plp1507/ic-emg/protese/teste_vna1.txt

-9.70184326E+00
-9.70123291E+00
-9.70770264E+00
-9.70526123E+00
-9.69769287E+00
-9.69238281E+00
-9.67559814E+00
-9.66070557E+00
-9.63366699E+00
-9.60742188E+00
-9.54473877E+00
-9.50756836E+00
-9.46258545E+00
-9.42108154E+00
-9.37390137E+00
-9.32885742E+00
-9.28045654E+00
-9.23321533E+00
-9.18292236E+00
-9.13580322E+00
-9.05548096E+00
-9.00695229E+00
-8.96289825E+00
-8.91785431E+00
-8.87543869E+00
-8.83381653E+00
-8.79611969E+00
-8.76023102E+00
-8.72811127E+00
-8.70223236E+00
-8.67369843E+00
-8.65395355E+00
-8.63709259E+00
-8.61933899E+00
-8.60128784E+00
-8.58212280E+00
-8.56149292E+00
-8.53753662E+00
-8.50477600E+00
-8.46829224E+00
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
