plp1507/ic-emg/protese/relatorios_ant/Relatorio Parcial_Renan Prando Davanzo.pdf

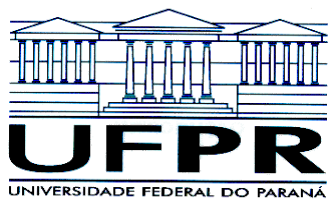
[picture p20: figure]

MINISTÉRIO DA EDUCAÇÃO
UNIVERSIDADE FEDERAL DO PARANÁ PRÓ-REITORIA DE PESQUISA E PÓS-GRADUAÇÃO COORDENADORIA DE INICIAÇÃO CIENTÍFICA E INTEGRAÇÃO ACADÊMICA PROGRAMA DE INICIAÇÃO CIENTÍFICA E EM DESENVOLVIMENTO TECNOLÓGICO E INOVAÇÃO

RENAN PRANDO DAVANZO

RELATÓRIO PARCIAL

INICIAÇÃO CIENTÍFICA:
PIBIC CNPq ( ), PIBIC CNPq Ações Afirmativas ( ), PIBIC UFPR TN ( ), PIBIC Fundação Araucária ( ), PIBIC Voluntária ( X ), Jovens Talentos ( ), PIBIC EM ( ).

INICIAÇÃO EM DESENVOLVIMENTO TECNOLÓGICO E INOVAÇÃO: PIBITI CNPq ( ), PIBITI UFPR TN ( ), PIBITI Funttel ou PIBITI Voluntária ( ).

(Período no qual esteve vinculado ao Programa 12/2017 a 07/2018)

ANÁLISE DE CIRCUITOS PARA APLICAÇÃO EM ELETROMIOGRAFIA

Relatório | Parcial | apresentado | à
Coordenadoria de Iniciação Científica
e | Integração | Acadêmica | da
Universidade Federal do Paraná -Edital 2017/2018 (ano de início e término do Edital).

Marlio Bonfim / Departamento de Engenharia Elétrica

Estudo de Estruturas Magnéticas para Eletrônica de Spin / 2006019145

CURITIBA
2018

ANÁLISE DE CIRCUITOS PARA APLICAÇÃO EM ELETROMIOGRAFIA

RESUMO

O documento relata o trabalho de pesquisa desenvolvido em uma das etapas do projeto de pesquisa, em que aborda o uso de um circuito eletrônico de tratamento de sinais SEMG (eletromiografia de superfície) de baixo-custo, tamanho reduzido e favorável para aplicação em tecnologias “wearables”.

Palavras-chave: Instrumentação, Bioengenharia, Eletromiografia

### 1. INTRODUÇÃO

Os sistemas de aquisição e processamento de sinais biomédicos permitem a análise de estruturas e de processos biológicos e fisiológicos, auxiliando médicos e pesquisadores no processo de diagnósticos e tratamento de doenças ou estudo do corpo humano. Com o avanço da tecnologia e a interdisciplinaridade de campos científicos, a bioengenharia evolui consideravelmente e hoje ocupa um papel importante na medicina - contribuindo com melhorias ou com novidades de métodos de análise de sinais biomédicos - e também na economia -abrindo maiores possibilidades de comercialização de produtos (de monitoramento fisiológico, por exemplo) para cidadãos comuns.
A bioengenharia é um ramo interdisciplinar de engenharia que varia desde a análise teórica, empreendimentos não experimentais para aplicações de última geração [1], utilizando conceitos de biologia, química, elétrica, mecânica, óptica, dentre outros, para auxiliar a área médica. A instrumentação biomédica é uma de suas áreas de estudo, envolvendo aquisição de sinais biológicos, tais como ciclo cardíaco e contração muscular, utilizando sensores e transdutores biomédicos. Os sensores e transdutores biomédicos são responsáveis por transformar sinais biológicos em sinais elétricos, e assim poderão ser tratados e processados por um sistema eletrônico capaz de armazenar esses dados em uma unidade de memória digital ou transmiti-los de alguma forma a um sistema seguinte.
Para detectar movimentos musculares, podemos usar, dentre outros sensores, eletrodos de eletromiografia de superfície. SEMG (Eletromiografia de superfície) é uma técnica não-invasiva para medição da atividade elétrica no músculo que ocorre durante ciclos de contração e relaxamento muscular [2]. Os eletrodos emitem sinais elétricos que devem ser tratados, buscando eliminar ruídos e sinais fora da faixa de frequência desejada e amplificar a amplitude do sinal para viabilizar um processamento digital.
O projeto atualmente se encontra no desenvolvimento de um amplificador de instrumentação para o tratamento de sinais SEMG de tamanho compacto, com poucos componentes e baixo preço de produção, buscando ser confiável, acessível economicamente no mercado e favorável para aplicação em tecnologias “wearables”. Espera-se, em seguida, aplicar o sistema de tratamento de sinais SEMG em sistemas digitais para processamento e aquisição digital para acionamento de próteses. A atuação do aluno está voltada à análise teórica, simulações computacionais e modelagem matemática do sistema, auxiliando nas escolhas dos componentes eletrônicos e contribuindo para a criação do método de projeto do circuito de amplificação proposto.

### 2. REVISÃO DA LITERATURA

Os amplificadores de instrumentação comumente realizam o tratamento do sinal através de diversos estágios, ou seja, são usados amplificadores e filtros em cascata [3] para adequar o sinal elétrico gerado pelos sensores, de modo a permitir a leitura desses sinais por um sistema de processamento ou aquisição digital. Porém, as aplicações de sistemas de aquisição e processamento de sinais SEMG caminham para tecnologias “wearables”, onde o trabalho de otimização de espaço do circuito eletrônico é essencial para a viabilidade prática do projeto [4].

### 3. MATERIAIS E MÉTODOS

3.1 O Sinal Eletromiográfico

O movimento muscular nos permite realizar tarefas como andar, ficar sentado e empurrar objetos graças às contrações musculares. A ação muscular é acionada por sinais elétricos recebidos de um nervo motor [5]. Pela Lei de Faraday, os sinais elétricos gerando ondas eletromagnéticas que se propagam pelos tecidos do corpo até a superfície corporal. Os eletrodos detectam essas ondas e transformam em pulsos elétricos. A amplitude do sinal SEMG é um sinal estocástico que pode ser razoavelmente representada por uma função distribuição Gaussiana. Amplitudes e bandas de frequências típicas são de 0 a 10 mV e 5 a 500 Hz [6], ilustrado na figura 1, a esquerda, a resposta no tempo onde podemos notar as amplitudes de tensão do sinal, e a direita, a resposta na frequência que mostra a região de frequências mais importantes para análise de sinais SEMG. A localização e o tipo de material do eletrodo mudam ligeiramente as características de detecção e sinal de saída.

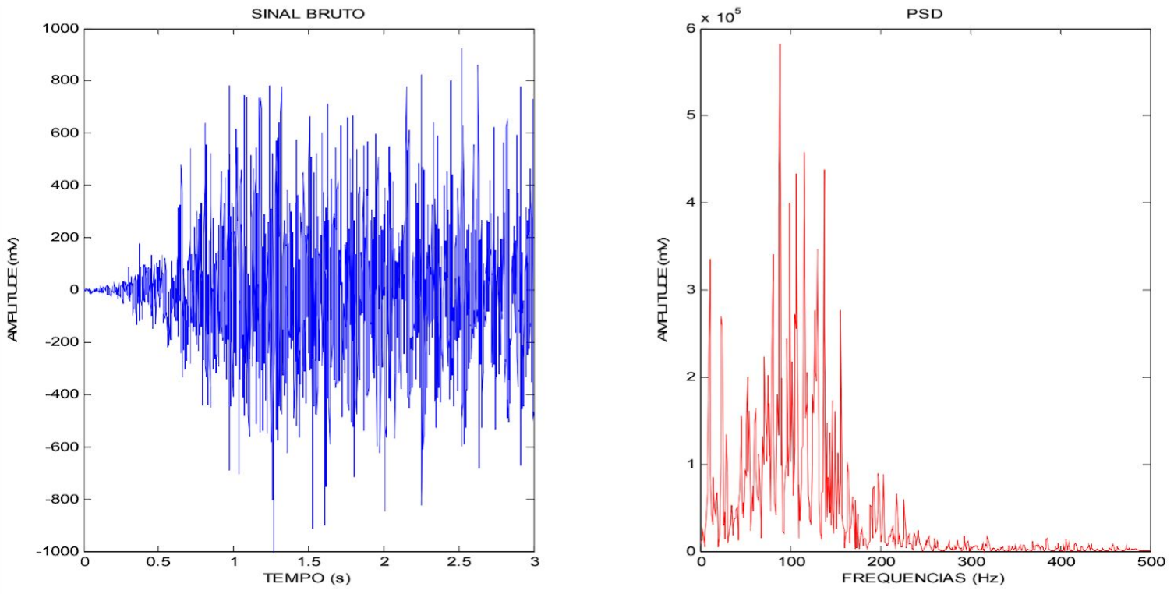
[picture p21: figure]

Figura 1: Gráfico representativo dos componentes do sinal EMG bruto (análise temporal e de frequências, respectivamente) [7]

3.2 - Sistema de tratamento do sinal SEMG

A utilização de um filtro de sinal se faz necessária para amplificar a amplitude do sinal e remover ruídos. O circuito projetado é composto por um amplificador diferencial para tratar sinais de dois eletrodos de eletromiografia de superfície. A amplificação diferencial detecta a diferença de potencial entre os eletrodos e cancela as interferências externas [8], como ruídos ambientes, movimento dos componentes, e inerentes aos próprios componentes utilizados, devido a rejeição de modo comum. Uma das fontes de ruído mais importantes é da alimentação na rede elétrica (60 Hz, no Brasil), e o tratamento de sinal deve atuar eficientemente para atenuar esse ruído a níveis desprezíveis de tensão. Além disso, o amplificador deve contar alta impedância de entrada, para o bom casamento de impedância alta do eletrodo.
O esquema elétrico do circuito projetado está representado na figura 2. Os eletrodos estão representados como fontes de tensão V1 e V2, conectadas na porta não inversora dos amplificadores operacionais OP1 e OP2, respectivamente. A relação entre as resistências dos resistores R1 e R2, além do ramo com o resistor RA e CA, afetam na amplificação do sinal SEMG (será discutido mais adiante).

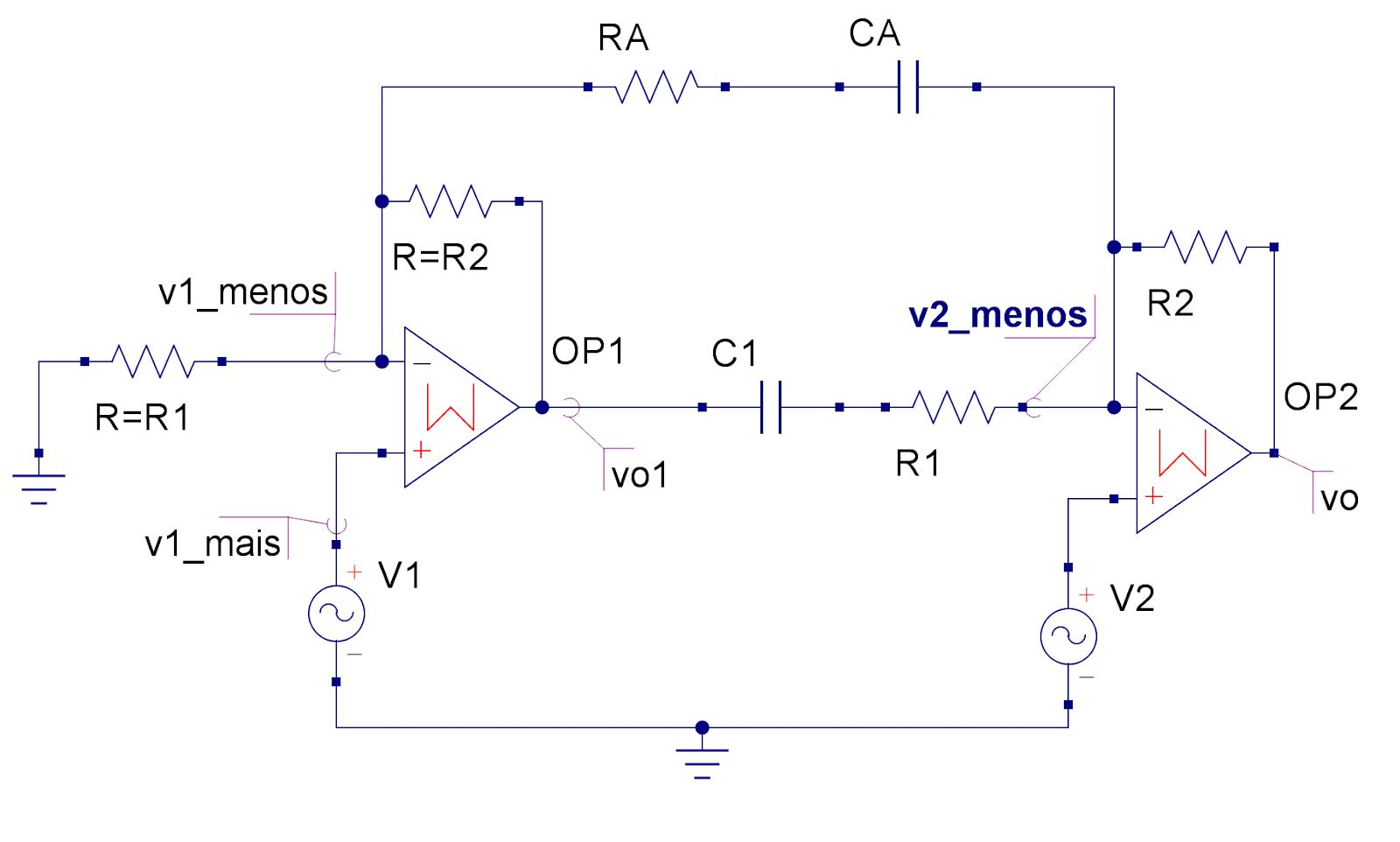
[picture p22: figure]

Figura 2: Esquema elétrico do circuito de tratamento de sinal sEMG

É utilizado o CI LM324N, um circuito integrado com quatro ampops (amplificadores operacionais) independentes, de alto ganho e com compensação interna de frequência [9]. Esses amplificadores apresentam resistência de entrada na ordem de 100 MΩ, ganho de malha aberta máximo de 1000 e CMRR mínimo de 60 dB para ganho unitário e 85 dB para ganhos entre 100 a 1000 [10].

3.3 Modelagem matemática do sistema de tratamento de sinal

O ganho de tensão de um amplificador diferencial é dado pela razão entre o nível de tensão na saída pela diferença entre os níveis de tensão dos sinais de entrada v1 e v2, ou seja

A (1)

v, dif =

vo
v −v 1 2
O ganho de tensão em modo comum é dado pela equação A (2)

v, cm =

vo
v +v 1 2
O fator de rejeição de modo comum é dado por

### CMRR = (3) Av, cm

Av, dif

Seja Ao o ganho de tensão do ampop. Os ampops com compensação interna de frequência, como do CI LM324N, apresentam o ganho Ao dependente da frequência do sinal de entrada de acordo com a equação no domínio de Laplace

Ao = | (4)

Go
1+
| s ωo

sendo Go o ganho de tensão do ampop em malha aberta e ωo a frequência angular de corte. [11]

Sejam R , | e | os valores da resistência elétrica dos resistores R1, R2 e R3, 1 | R2 | R3
respectivamente, do circuito apresentado na figura 2; C1 e CA os valores de capacitância dos
capacitores C1 e CA, respectivamente; v e | as tensões das fontes V1 e V2; e | e | as 1 | v2 | vn
− | vn

+

tensões nas portas inversora e não inversora, respectivamente, dos amplificadores operacionais (OPn, sendo n={1,2}) do circuito da figura 2.
A impedância da associação em série do resistor R1 e capacitor C1 pode ser representada pela expressão no domínio de Laplace
Z3 = R1 + | (5),
| 1 s·C1

assim como para RA e CA,
ZA = RA + | (6)
| 1 s·CA

Para modelagem matemática do circuito, analisamos primeiro o amplificador operacional OP1. Considerando impedância de entrada do OP1 infinita, fazemos a análise de nós (Lei das Correntes de Kirchhoff) no nó da porta inversora de OP1:

v | (7)
1

− =
2 +

R1
ZA

v +v · o1

−
2

R1
ZA

A tensão de saída de um amplificador operacional de tensão é o produto do ganho de tensão do amplificador operacional com a diferença de tensão entre a porta não inversora e a porta inversora.

Então, a tensão de saída de OP1 é dada pela equação
v | (8) o1 = Ao ·(v1 − v
1

−)

Fazendo o mesmo procedimento para OP2, temos, pela Lei das Correntes de Kirchhoff,

v | (9)
2
− = (R //Z //Z ) 1 | A | 3

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
+ Z3

vo1 )

e pela equação de tensão de saída de um amplificador operacional de tensão,
vo = Ao ·(v | (10) 2 − v
2

−)

Então, podemos encontrar v :
1

−

v | v
1

− = vo ·

ZA

R //Z //Z
1 3 A
2+Ao+ +R · | · | −

R1
ZA

1 ZA

R //Z //Z
1 A 3

( Z
3

Ao 1 ZA)

+ v1

·

Ao·(1+ · Z
3

R1
ZA

R //Z //Z
1 3 A

)

2+Ao+ +R · | · | −

R1
ZA

1 ZA

R //Z //Z
1 A 3

( Z
3

Ao 1

ZA)

### = vo · A + 1

- B

(11)
sendo
A = | (12)

ZA

R //Z //Z
1 3 A
2+Ao+ +R · | · | −

R
1
ZA

1 ZA

R //Z //Z 1 A 3

| ( Z3
Ao | 1

ZA)

e

B = | (13) .

Ao·(1+ · Z

3

R
1
ZA

R //Z //Z

1 3 A )

2+Ao+ +R · | · | −

R
1
ZA

1 ZA

R //Z //Z 1 A 3

| ( Z3
Ao | 1

ZA)

Reescrevendo (9),

v | (14)
2
− = (R //Z //Z ) 1 | A | 3

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
(v1 − v
1

−)]

Assim, substituindo v da equação (11) em (9): 1

−

v | (15) 2
− = (R //Z //Z ) 1 | A | 3

·[vo

·(
1
R1

+

A
ZA

− Z3

Ao

·A

) + v1

·(
B
ZA

+

Ao
Z3

− Z3

Ao

·B

)]

Finalmente, substituindo v (15) em (10), 2

−

vo= | (16)

Ao
1+Ao·(R //Z //Z )· | + − 1 | A | 3 (
1
R1

A
ZA

Z3

Ao·A

)

·[v2 − v1
- (R //Z //Z ) 1 | A | 3

·(
B
ZA

+

Ao
Z3

− Z3

Ao·B

)]

A equação completa da tensão de saída, substituindo A e B, é dada a seguir

vo =

Ao

1+Ao

·(R //Z //Z )· | + | · | − 1 | A | 3 [

1
R
1

ZA

R //Z //Z 1 3 A

2+Ao+ | +R · | · | −

R
1
ZA

1 ZA

R //Z //Z
1 A 3

(Z
3

Ao 1

ZA )

(
1
ZA

Z
3

Ao

)]

·{v2 − v1
- (R //Z //Z ) 1 | A | 3

·[ Z3
Ao +

A · 1+ · o ( Z

3

R1
ZA

R //Z //Z 1 3 A

)

2+Ao+ +R · | · | −

R1
ZA

1 ZA

R //Z //Z 1 A 3

( Z

3

Ao 1 ZA )

·(
1
ZA

− Z3

Ao·1

)]}

(17)

Portanto, obtemos os ganhos de tensão diferencial Av, dif e comum Av, cm

Adif =

Ao

1+Ao

·(R //Z //Z )· | + | · | − 1 | A | 3 [

1
R
1

ZA

R //Z //Z 1 3 A

2+Ao+ | +R · | · | −

R
1
ZA

1 ZA

R //Z //Z
1 A 3

(Z
3

Ao 1

ZA )

(
1
ZA

Z
3

Ao

)]

·{1 + (R //Z //Z ) 1 | A | 3

·[ Z3
Ao +

A · 1+ · o ( Z

3

R1
ZA

R //Z //Z 1 3 A

)

2+Ao+ +R · | · | −

R1
ZA

1 ZA

R //Z //Z 1 A 3

( Z

3

Ao 1 ZA )

·(
1
ZA

− Z3

Ao·1

)]}

(18)

Acm =

Ao

1+Ao

·(R //Z //Z )· | + | · | − 1 | A | 3 [

1
R
1

ZA

R //Z //Z 1 3 A

2+Ao+ | +R · | · | −

R
1
ZA

1 ZA

R //Z //Z
1 A 3

(Z
3

Ao 1

ZA )

(
1
ZA

Z
3

Ao

)]

·{1 − (R //Z //Z ) 1 | A | 3

·[ Z3
Ao +

A · 1+ · o ( Z

3

R1
ZA

R //Z //Z 1 3 A

)

2+Ao+ +R · | · | −

R1
ZA

1 ZA

R //Z //Z 1 A 3

( Z

3

Ao 1 ZA )

·(
1
ZA

− Z3

Ao·1

)]}

(19)

Com isso, o fator de rejeição de modo comum é dado por

CMRR = | (20) Acm

Adif =
1−(R //Z //Z )· | + | · | − 1 | A | 3 [ Z

3

Ao

Ao· 1+ · ( Z3
R
1
ZA

R //Z //Z
1 3 A

)

2+Ao+ | +R · | · | −

R1
ZA

1 ZA

R //Z //Z 1 A 3

| | (Z3 | Ao 1

ZA)

(
1
ZA

Z
3

Ao·1

)]

1+(R1

//ZA

//Z3

)·[ + | · | − Z3

Ao

Ao· 1+ · ( Z
3

R
1
ZA

R //Z //Z
1 3 A

)

2+Ao+ | +R · | · | −

R
1
ZA

1 ZA

R //Z //Z
1 A 3

(Z

3

Ao 1

ZA)

(
1
ZA

Z3

Ao·1

)]

O ganho de tensão na faixa de frequências da banda passante pode ser calculado considerando a resposta do circuito para sinais contínuos. Para isso, utiliza-se o conceito de curto circuito virtual para amplificadores operacionais com realimentação negativa não saturados (tensão na entrada não inversora igual a inversora). A tensão de saída vocc do sistema para entrada em corrente contínua é expressa pela equação
vocc = | (21) (v | ) 2 − v1

·(1 + R1
R2 + 2 · RA

R1 )

Considerando R2 = R1 e entrada diferencial, ou seja, v2 =− v1 , temos o ganho de tensão
em modo diferencial GM | do sistema para sinais contínuos AX
GM | (22) AX = 4 + 4 · RA

R1

Para o cálculo da frequência de corte passa baixa f 2 do sistema, considera-se f 2

igual a
frequência de corte do ampop OP2, que pode ser descrita pela equação do produto ganho banda. Assim,
GBP = Go · f o = GMAX
- f (23) 2
Então, temos a frequência de corte passa baixa f 2 do sistema
f 2 = | (24)

GBP
GM ·f AX 2
Observou-se que, apesar do reduzido tamanho físico, o circuito apresenta um aumento da complexidade de cálculo da função transferência. Então, foram adotadas técnicas estatísticas para as definições dos parâmetros do amplificador restantes, explicitadas na seção 3.3.

3.3 - Simulações do sistema em programas computacionais

Através do software de simulação de circuitos eletrônicos QUCS, pôde-se validar as equações teóricas, analisar a resposta do sistema no domínio da frequência e encontrar margens de valores dos componentes eletrônicos favoráveis a aplicação proposta.

Temos na figura 3 a seguir gráficos de tensão de saída em modo comum (curva Vocm.v), tensão de saída em modo diferencial (curva Vodif.v) e taxa de rejeição em modo comum (curva CMRR) gerados a partir de uma análise paramétrica da resposta do circuito na frequência, num intervalo de 5 Hz a 1 kHz, com valores de RA = 100 Ω , CA = 110 μF , GBP = 1 MHz (produto ganho banda do amplificador operacional de tensão), f o = 10 Hz (frequência de corte) e
C | 00 nF , com | variando num intervalo linear de [60;200] kΩ. 1 = 1 | R1

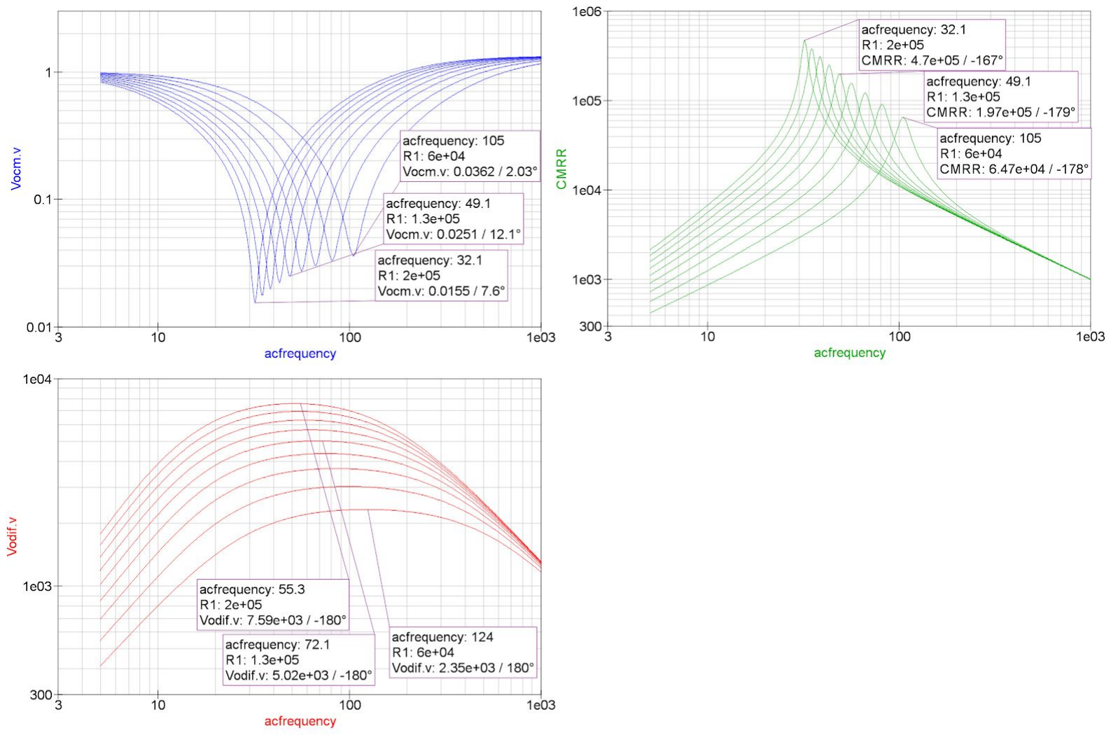
[picture p23: figure]

Figura 3: Respostas na frequência do amplificador em análise paramétrica em R1: saída para modos diferencial e comum e CMRR

Podemos analisar pela figura o desempenho do sistema em modo diferencial e comum. No modo diferencial, temos um filtro passa banda, com a banda passante e o ganho nessa faixa variável em relação ao valor de R1. As possibilidades de banda passante com a variação dos valores de R1 são favoráveis à aplicação, pois se encontram na faixa de frequências do sinal

SEMG. Além disso, ganho na ordem de kV é suficiente para amplificar sinais SEMG para sistemas de aquisição digital por microcontroladores com entrada analógica de 0 a 12V.

Para que o filtro seja eficiente na eliminação do ruído da alimentação (50 ou 60 Hz), o fator de rejeição em modo comum (CMRR) deve ter seu menor valor numa frequência igual ou muito próxima a da rede de alimentação. Ou seja, os valores dos componentes do circuito devem ser definidos de forma que, na resposta em frequência, a frequência central f dip da

tensão de saída vo com a entrada em modo comum seja aproximadamente igual a frequência de 50 ou 60 Hz.
Devido a complexidade das equações teóricas encontradas para descrever o comportamento do circuito, foram realizadas simulações do circuito pelo software QUCS para coletar dados da frequência f (frequência central da resposta em frequência do amplificador dip

em modo comum) e da frequência passa-altas f em intervalos de valores dos parâmetros 1 R1 = [80; 130] kΩ , RA = [80; 130] kΩ , C1 = [90; 200] nF , CA = [80; 130] μF e GBP = [0, 6; 2] MHz , resultando nas aproximações
f | , | (25) dip = 0 2 ·√ C ·R1 1

2

GBP·RA

f | , | (26) 1 = 0 2 ·

1
√R1
·C1

·RA

·CA
sendo GBP o valor do produto ganho banda do amplificador operacional.

3.4 Método de projeto do sistema

Foi desenvolvido um método para projetar o circuito amplificador de sinais SEMG utilizando as equações demonstradas, e será demonstrado através de um exemplo. Caso deseja-se um amplificador com ganho máximo na banda passante de 3,9 kV (Gdesejado = 3, 9 kV /V ) , com alimentação numa linha de distribuição de energia em corrente

alternada de frequência 60 Hz (fdip = 60 Hz) e banda de passagem entre 19 Hz e 256,410 Hz (
f | 9 Hz e | ), calcula-se primeiro os valores dos resistores R1 e RA. 1 = 1 | f | 56, 10 Hz 2 = 2 | 4
Da equação (22), temos
GM | R | (27) AX = 4 + 4 ·

R1
RA ⇒ 1 = RA
- 4

G − 4 MAX

Sendo GMAX = Gdesejado = 3, 9kV /V , podemos atribuir o valor para o resistor RA = 100Ω , e assim

R | 00 | 7, kΩ (28) 1 = 1 · 4

3,9k − 4 = 9 4

Para a escolha do ampop, calcula-se o parâmetro do produto ganho banda

GBP = f | 56, 10 , e3 | MHz (29) 2
| · GMAX = 2 | 4 · 3 9 = 1

Utilizando as equações (25) e (26), podemos calcular os valores dos capacitores C1 e CA.

fdip = 0, 2 · | C | , | 17, 22 nF (30) √ C ·R1 1

2

GBP·RA | ⇒ | 1 = 0 2
| | 2
·

GBP·RA
fdip²·R1
2 ≃ 1 | 1
f | , | , | 7, 304 uF (31) 1 = 0 2 ·

1
√R1
·C1

·RA

·CA

⇒ CA = 0 2

2
·

1
f ·R ·C ·R 1

2
1 1 A

≃ 9 1

Com todos os parâmetros definidos, o circuito pode ser testado computacionalmente para comparar o desempenho solicitado (coluna “Teórico” da tabela ) com o desempenho na simulação. Usando os valores dos componentes do circuito (R1, C1, RA, CA e GBP) calculados, usou-se o software de simulação QUCS para coletar os dados do circuito, que estão na coluna “Simulação” da tabela 1. A diferença percentual entre o valor teórico e o coletado da simulação está representado na coluna “Erro”.

| Teórico | Simulação | Erro
Ganho | 3,9k | 3,79600k | -2,66667%
fdip | 60 Hz | 60,0717 Hz | 0,11950%
f1 | 19 Hz | 20,2650 Hz | -6,65789%

Tabela 1: Análise dos valores de desempenho do circuito calculados pelas equações encontradas e coletados da simulação computacional

Os baixos valores de erro encontrados confirmam a razoabilidade de se utilizar as equações definidas na seção 3.2 para o método de projeto proposto nesta seção, viabilizando a aplicação do sistema proposto para tratamento de sinais SEMG.

### 4. RESULTADOS E DISCUSSÃO

O circuito projetado apresenta respostas favoráveis para a aplicação em amplificação de sinais SEMG, com ganho diferencial na ordem de kV, banda de passagem ajustável e coerente com a aplicação e filtragem eficaz de ruídos da rede de alimentação e dos cabos dos sensores e interferências externas.

O tamanho reduzido do circuito amplificador favorece seu uso em tecnologias “wearables”, ampliando a gama de aplicações desse sistema. Além disso, diminui o custo e aumenta a viabilidade econômica de utilização em larga escala para o mercado consumidor. Foram confeccionadas placas de circuito impresso do circuito, onde podemos ver na figura 4 duas delas (face anterior e posterior) para efeito de comparação com uma moeda de 50 centavos.

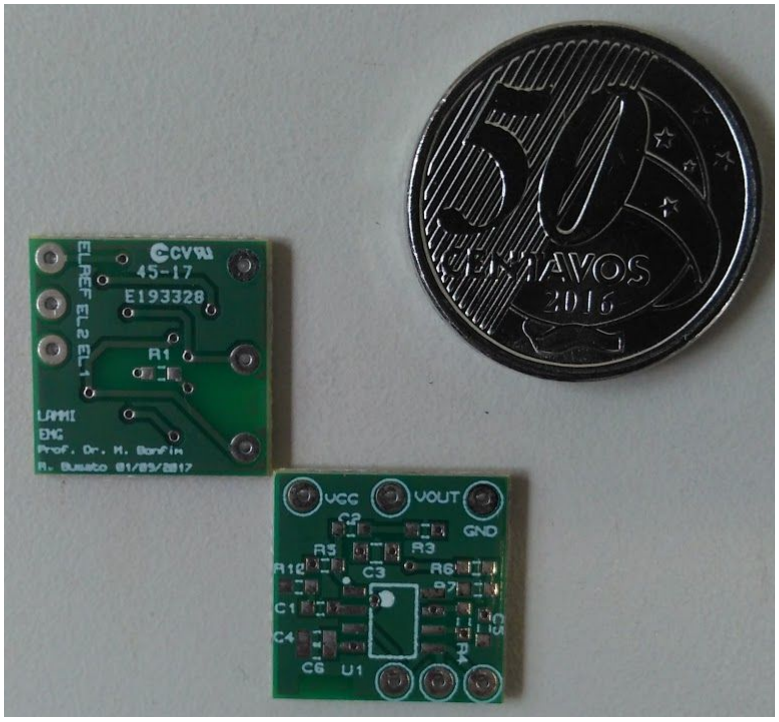
[picture p24: figure]

Figura 4: Placa de circuito impresso do sistema de tratamento de sinais SEMG

Na figura 5, temos a placa do circuito projetado a direita. A esquerda da figura (?), está a placa EMG Sensor v7.1.2.1 da Advancer Techonologies, com público consumidor de hobbystas [...] e estudantes [12].

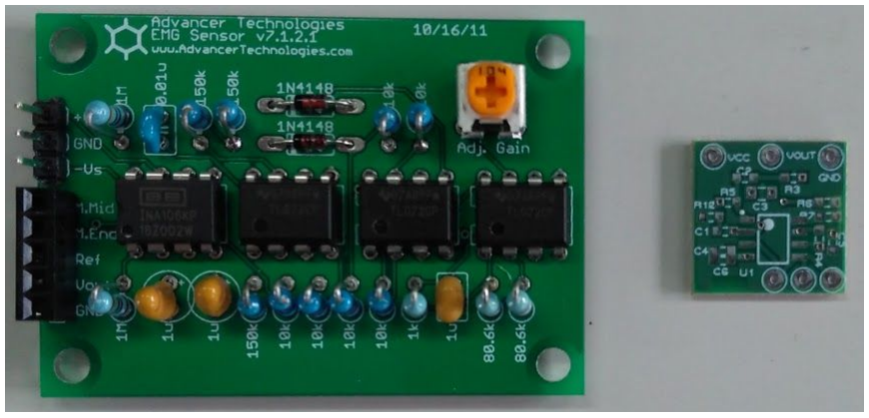
[picture p25: figure]

Figura 5: Comparação de tamanho entre EMG Sensor v7.1.2.1 da Advancer Techonologies e a placa do circuito projetado neste projeto de pesquisa

### 5. REFERÊNCIAS

Listar as referências utilizadas no texto, segundo nomas da ABNT ou a utilizada na área da CAPES
[1] Enderle, J.D., Blanchard, S.M., Bronzino, J.D. Introduction to Biomedical Engineering. In: ed. Elsevier Academic Press, 2005.
[2] THOUGHT TECHNOLOGY LTD 2008. Basics of Surface Electromyography Applied to Psychophysiology.
Disponível em:
<http://www.thoughttechnology.com/pdf/manuals/MAR900-01%20SEMG%20applied%20to%20p sychophysiology.pdf>. Acesso em: 08 fev. 2018.
[3] Chung, W., & Rachim, V.P. (2016). Wearable Noncontact Armband for Mobile ECG Monitoring System. IEEE Transactions on Biomedical Circuits and Systems 10: 1112-1118.
[4] Karpul, D. Cohen, G. Gargiulo, G. D. van Schaik, A. McIntyre, S. Breen, P. P. (2017) Low-power transcutaneous current stimulator for wearable applications. BioMedical Engineering OnLine 16:118
[5] COTTERIL, R. M. J. Biophysics: An Introduction. Hoboken, NJ: John Wiley & Sons, 2002.
[6] GAMET, D.; FOKAPU, O. Electromyography. Laboratory Of Biomechanics And Bioengineering, UMR CNRS 6600, Research Center, Royallieu, University Of Technology Of Compiègne, Compiègne, França: [s.n.], 2008. 1 p. Disponível em: <http://www.utc.fr/umr6600/doc/ABS/EBBE_DGamet.pdf>. Acesso em: 08 fev. 2018.
[7] MARCHETTI, P. H. DUARTE, M. Instrumentação em Eletromiografia. Laboratório de Biofísica, Escola de Educação Física e Esporte, Universidade de São Paulo. Av. Prof. Mello de Moraes, 65, 05508-030, São Paulo, São Paulo, Brasil: [s.n.], 2006. Disponível em: <http://ebm.ufabc.edu.br/publications/md/EMG.pdf>. Acesso em: 08 fev. 2018
[8] KONRAD, P. The ABC of EMG: A practical introduction to Kinesiological Electromyography. Scottsdale Road, Suite 104 Scottsdale, Arizona 85254: Noraxon U.S.A., Inc., 2006. 13 p. Disponível em:
<https://www.noraxon.com/wp-content/uploads/2014/12/ABC-EMG-ISBN.pdf>. Acesso em: 16 fev. 2018.
[9] Texas Instruments Inc., “LMx24-N, LM2902-N Low-Power, Quad-Operational Amplifiers Datasheets” - 2015- SNOSC16D
[10] BONFIM, M. J. C. THÖNKE, I. ANDRADE, A. M. F. (2017) Circuit of Collection and Storage of Electromyographic Signals. In:1:3
[11] SEDRA, A. S. & K. C. SMITH. Microelectronic Circuits. 3. ed. Oxford University Press, 1998.
[12] Advancer Technologies LLC, “MyoWare Muscle Sensor“ - 2017. Disponível em: <http://www.advancertechnologies.com/p/myoware.html >

[13] DeLuca, C.J. “Electromyography”. Em J. G. Webster, ed, Encyclopedia of Medical Devices and Instrumentation. 2a ed. New York, 2006, Vol. 3, pp.98-109.
[14] Guyton, A. C. Tratado de Fisiologia Médica. 12 a ed. Rio de Janeiro: Elsevier, 2011.
