plp1507/ic-emg/protese/testes_ampl_protese/teste_dif1.txt

-24.4060669E+00
-24.4142456E+00
-24.4224854E+00
-24.4293213E+00
-24.4338989E+00
-24.4323730E+00
-24.4209595E+00
-24.3962402E+00
-24.3560791E+00
-24.2996826E+00
-24.1500854E+00
-24.0556984E+00
-23.9573708E+00
-23.8575630E+00
-23.7558289E+00
-23.6487274E+00
-23.5340424E+00
-23.4114838E+00
-23.2822723E+00
-23.1507721E+00
-22.9375916E+00
-22.8227539E+00
-22.7152100E+00
-22.6123962E+00
-22.5128174E+00
-22.4141541E+00
-22.3141174E+00
-22.2131348E+00
-22.1107788E+00
-22.0084839E+00
-21.8723755E+00
-21.7753906E+00
-21.6807861E+00
-21.5875854E+00
-21.4952393E+00
-21.4040527E+00
-21.3134766E+00
-21.2236938E+00
-21.1347656E+00
-21.0479469E+00
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
