plp1507/ic-emg/protese/testes_ampl_protese/teste_dif2.txt

-24.3997192E+00
-24.4057617E+00
-24.4113159E+00
-24.4149170E+00
-24.4149170E+00
-24.4082642E+00
-24.3919678E+00
-24.3657837E+00
-24.3281250E+00
-24.2759399E+00
-24.1348877E+00
-24.0418930E+00
-23.9378395E+00
-23.8243561E+00
-23.7022018E+00
-23.5728912E+00
-23.4396362E+00
-23.3080292E+00
-23.1807251E+00
-23.0601807E+00
-22.8704224E+00
-22.7652283E+00
-22.6635132E+00
-22.5642700E+00
-22.4659119E+00
-22.3675537E+00
-22.2679443E+00
-22.1677246E+00
-22.0681763E+00
-21.9706421E+00
-21.8421631E+00
-21.7495728E+00
-21.6590576E+00
-21.5701904E+00
-21.4814453E+00
-21.3905029E+00
-21.2974243E+00
-21.2034302E+00
-21.1097412E+00
-21.0176163E+00
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
