plp1507/ic-emg/protese/schem/Assembly .PDF

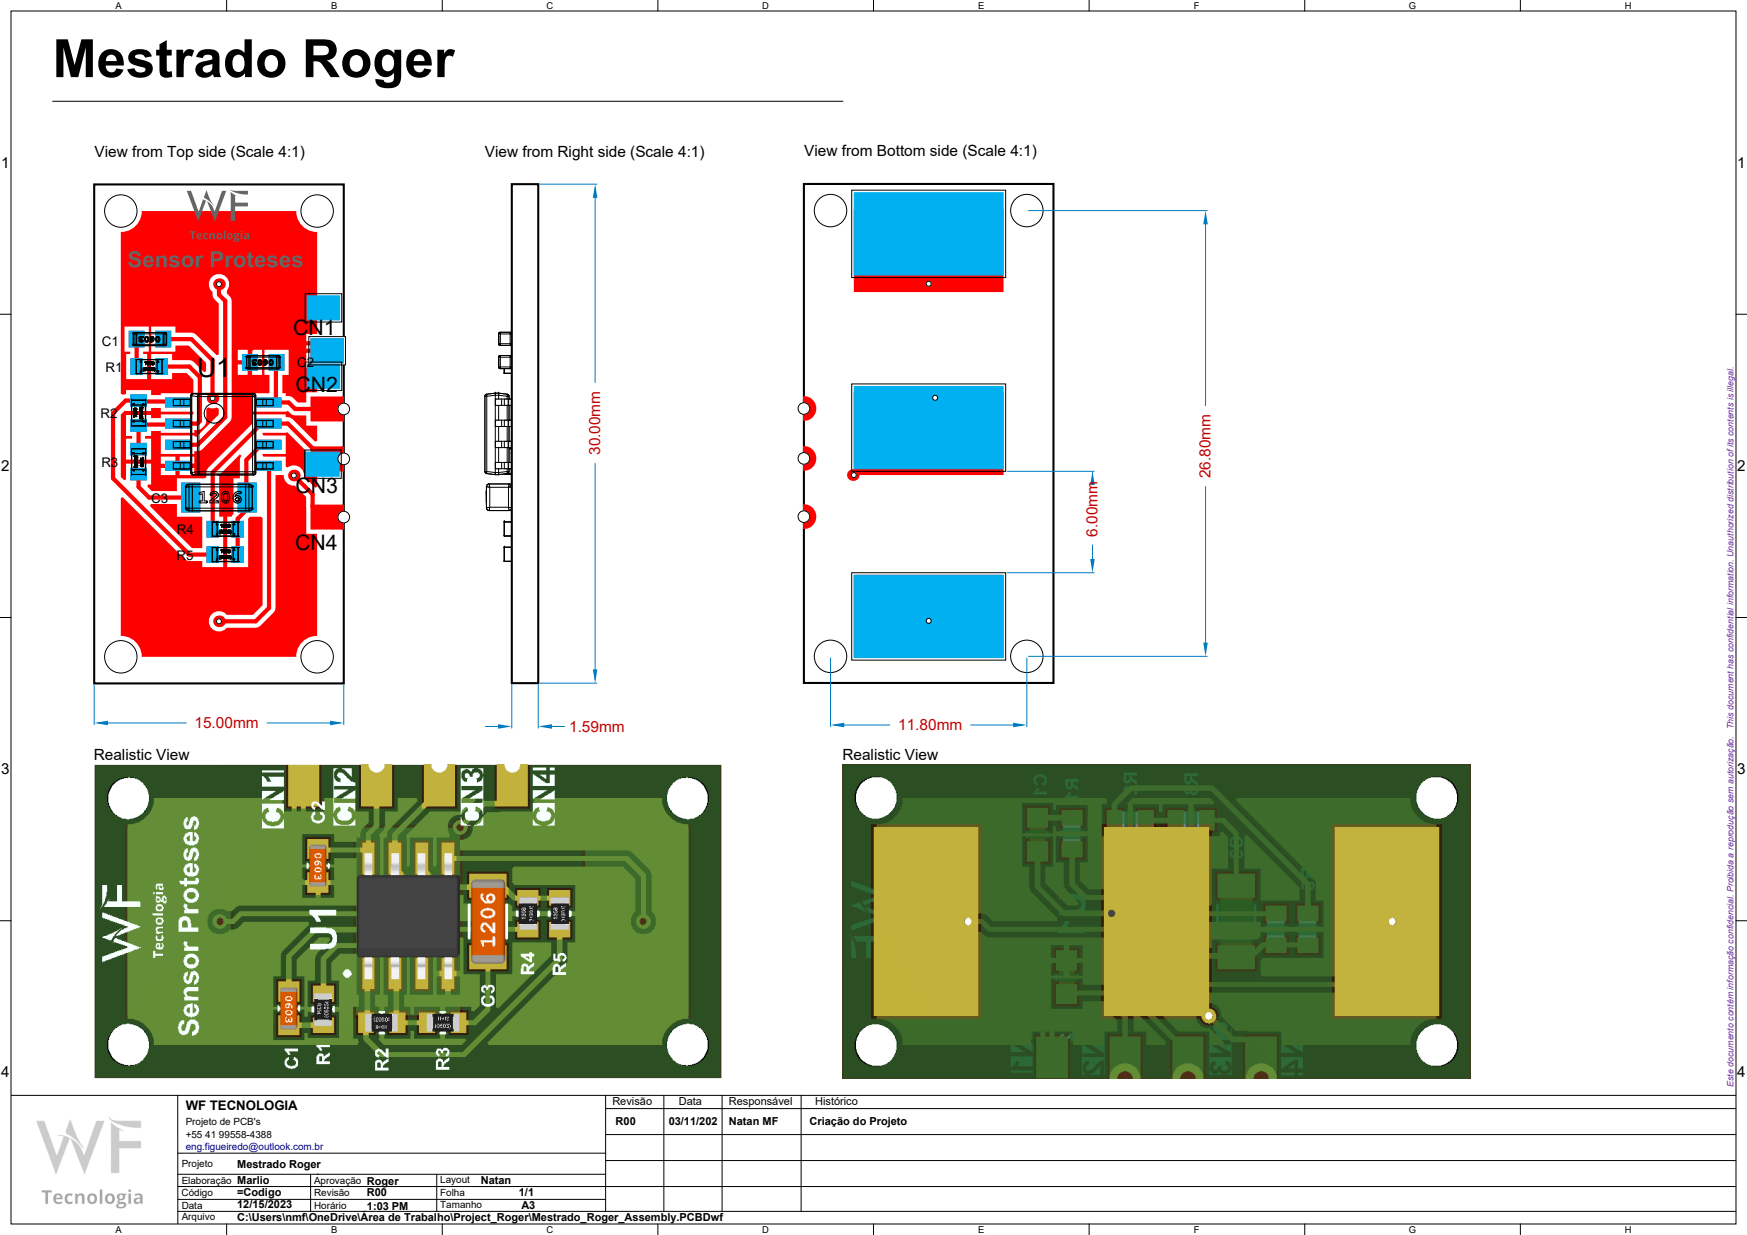
[picture p26: page 1]

Este documento contém informação confidencial. Proibida a reprodução sem autorização. This document has confidential information. Unauthorized distribution of its contents is illegal.

Mestrado Roger
Marlio
=Codigo
C:\Users\nmf\OneDrive\Área de Trabalho\Project_Roger\Mestrado_Roger_Assembly.PCBDwf
