plp1507/ic-emg/protese/schem/Schematic Prints.PDF

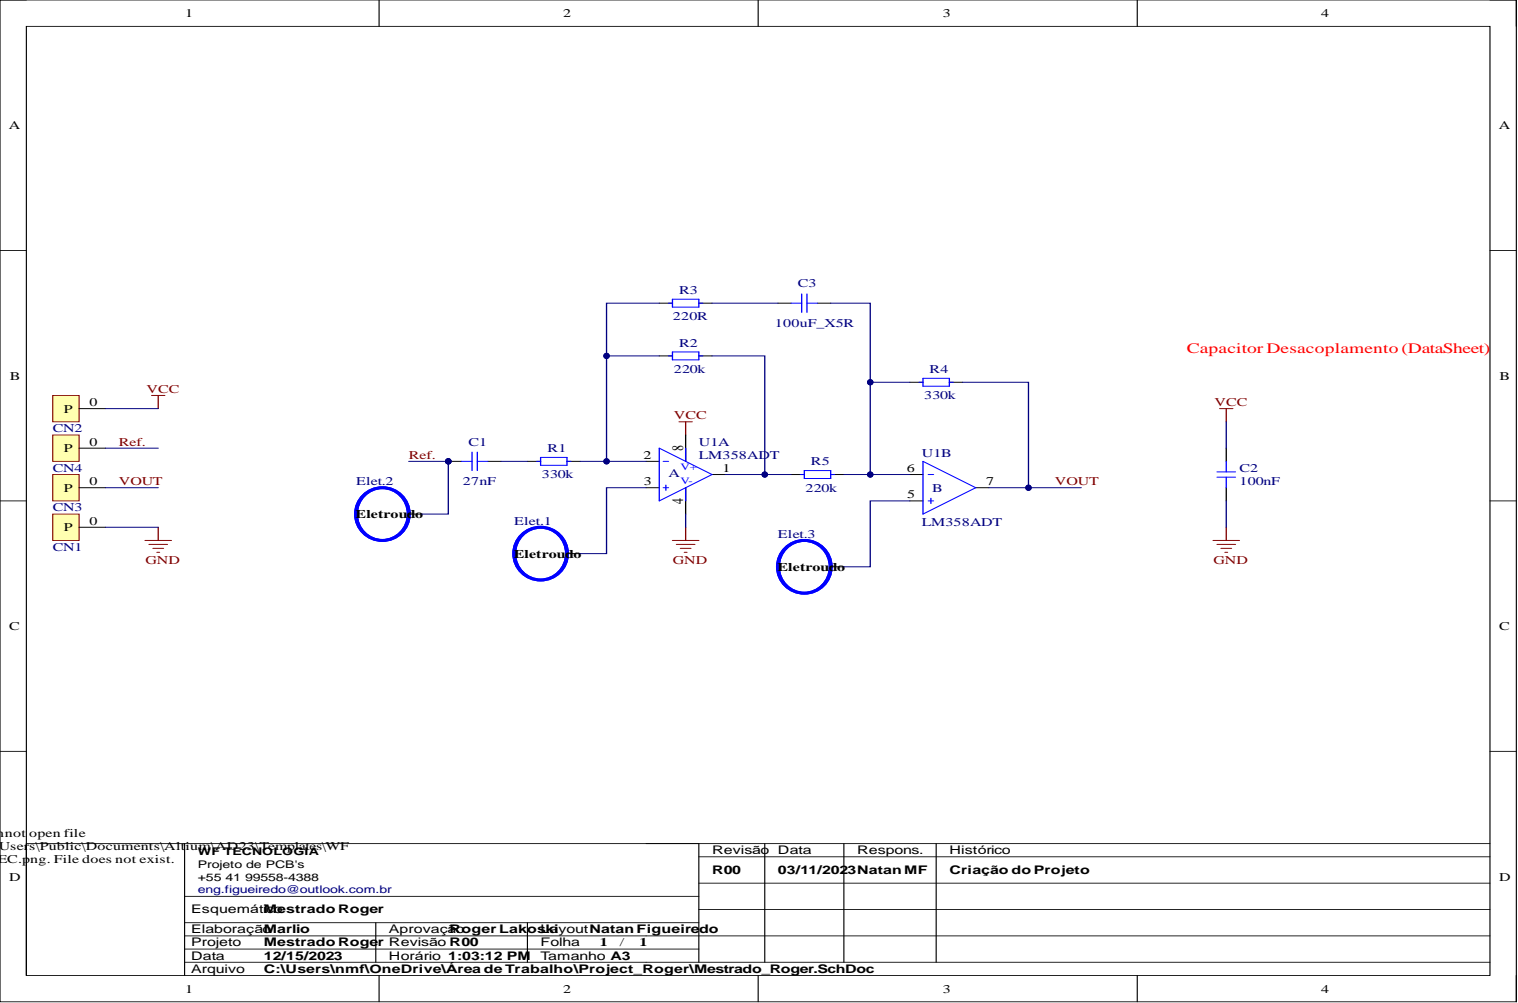
[picture p27: page 1]
